kike-canaries/FifeFancy/pcb/3Dshapes/APFA2507.step

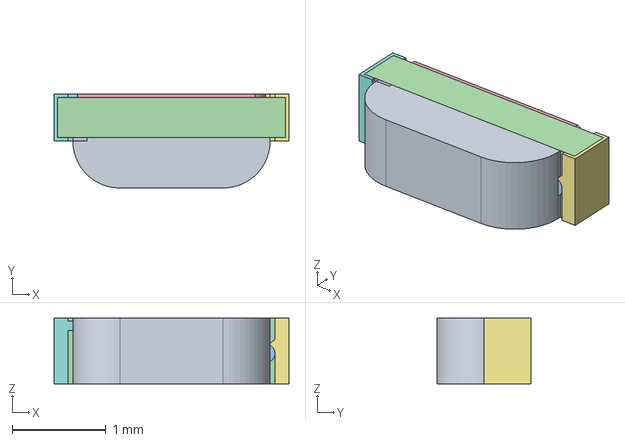
[picture p1: CAD file, 2021-09-05]
pcb/3Dshapes/APFA2507.step
2.50 x 1.00 x 0.7 mm
