kike-canaries/FifeFancy/pcb/3Dshapes/TL3340AF160QG.step

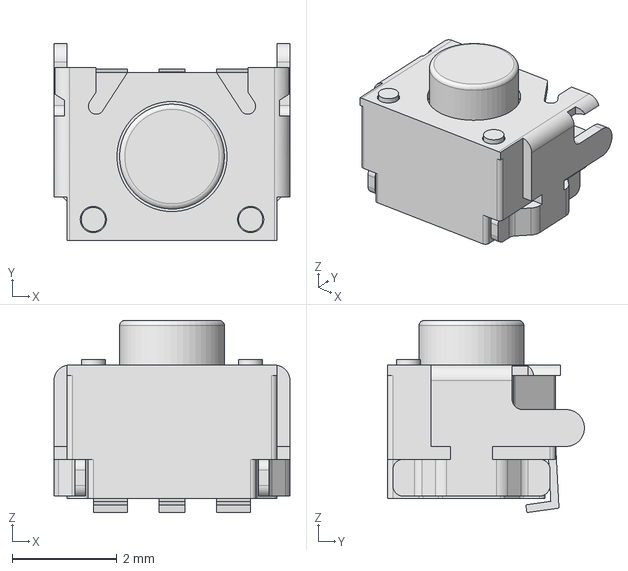
[picture p2: CAD file, 2021-09-05]
pcb/3Dshapes/TL3340AF160QG.step
4.50 x 3.75 x 3.67 mm
