kike-canaries/FifeFancy/pcb/3Dshapes/DX07P024MJ1R1500.step

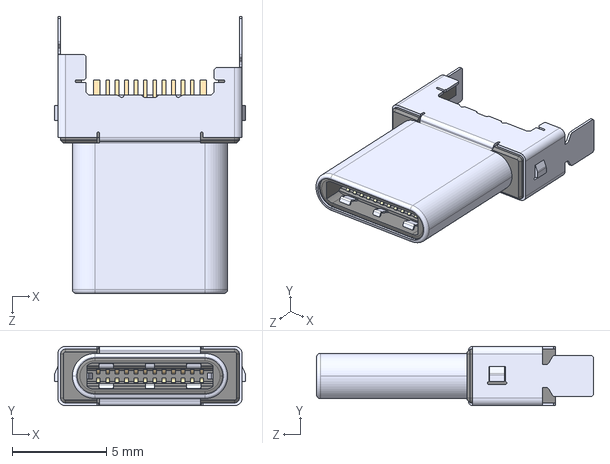
[picture p3: CAD file, 2021-09-05]
pcb/3Dshapes/DX07P024MJ1R1500.step
10.2 x 3.15 x 14.7 mm
