kike-canaries/FifeFancy/pcb/3Dshapes/XCL220.step

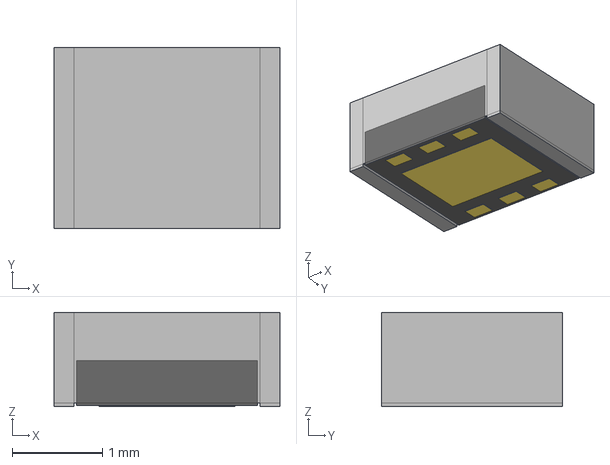
[picture p4: CAD file, 2021-09-03]
pcb/3Dshapes/XCL220.step
2.50 x 2.00 x 1.04 mm
