kike-canaries/FifeFancy/pcb/3Dshapes/W25Q16JVUXIQ_WIN.step

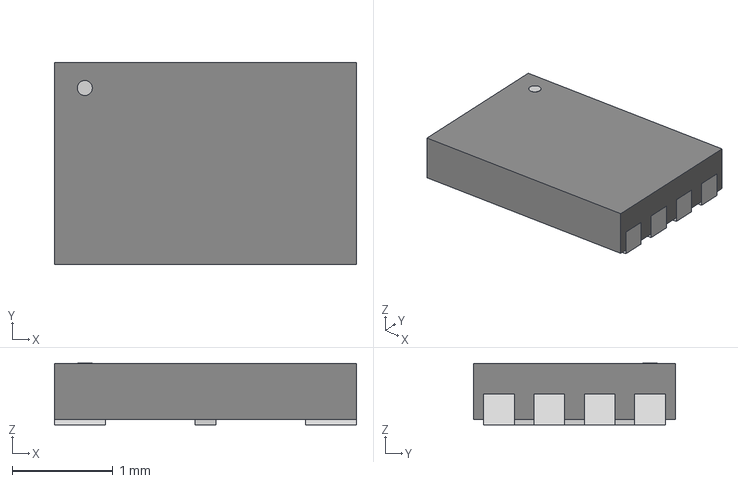
[picture p5: CAD file, 2021-09-03]
pcb/3Dshapes/W25Q16JVUXIQ_WIN.step
3.00 x 2.01 x 0.612 mm
