kike-canaries/FifeFancy/pcb/3Dshapes/Sensirion_CO2_Sensors_SCD4x_STEP_file.step

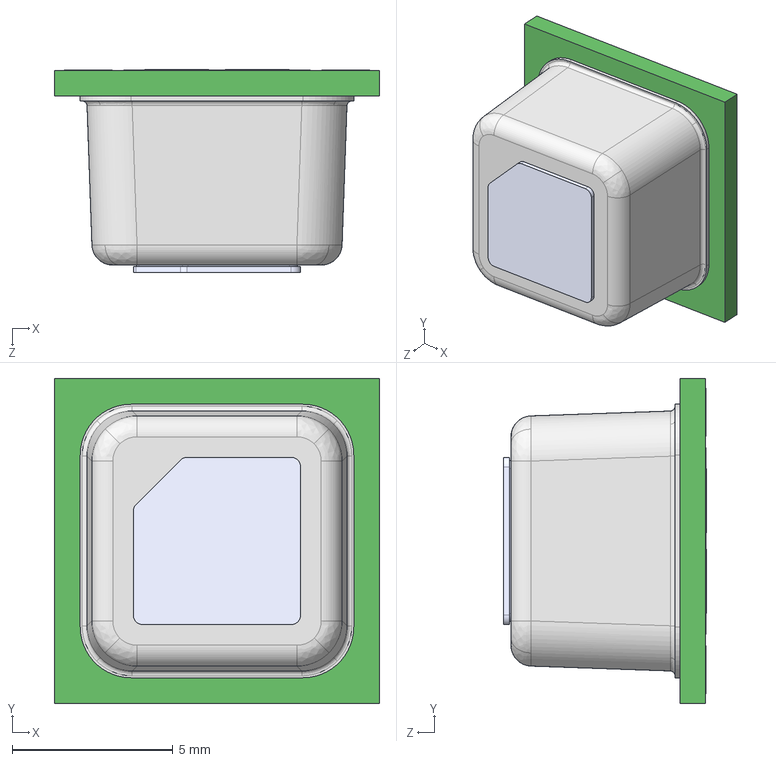
[picture p6: CAD file, 2021-09-01]
pcb/3Dshapes/Sensirion_CO2_Sensors_SCD4x_STEP_file.step
10.1 x 10.1 x 6.31 mm
