kike-canaries/FifeFancy/pcb/minimum.kicad_pcb

## KiCad design pcb/minimum.kicad_pcb (2021-09-07)

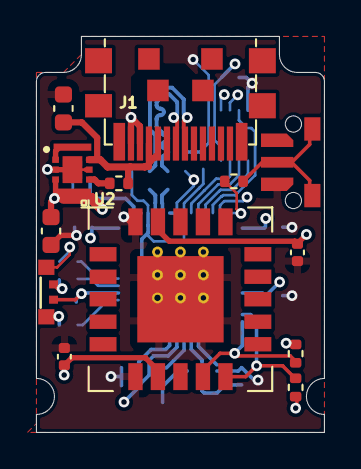
[picture p7: board minimum.kicad_pcb from above]

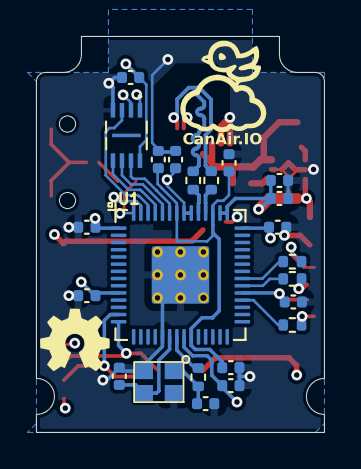
[picture p8: board minimum.kicad_pcb from below]

Board: 4 copper layers, 16.0 x 22.0 mm, 38 parts (25 on the bottom side), 28 nets.

Parts:
C1, C2, C3, C4, C5, C6, C7, C9, C12, C13, C16: 100n; C_0402_1005Metric
C8: 4.7u; C_0402_1005Metric
C10, C11: 1u; C_0402_1005Metric
C14, C15: 27p; C_0402_1005Metric
C17, C18: 10u; C_0603_1608Metric
D1: LED_BARG; RGB_LED_3x1
J1: DX07P024MJ1R1500; USB_C_Plug_UTC009-C12
LOGO1: LOGO; CanAir_IO
LOGO2: Logo_Open_Hardware_Small; OHW_LOGO
R1, R2: 27.4; R_0402_1005Metric
R3, R4: 2.2k; R_0402_1005Metric
R5, R6: 1k; R_0402_1005Metric
R7: 10k; R_0402_1005Metric
R8, R9, R10: 470; R_0402_1005Metric
SW1: SW_Push; TL3340AF160QG
U1: RP2040; RP2040-QFN-56
U2: SCD4x; QFN-20_EP_10.1x10.1_Pitch1.25mm
U3: W25Q16JVUXIQ
U4: XCL220
Y1: C2E-12.000-18-1020-X-R; AKER_C2E

Connections:
+1V1: C11.1, C12.1, C13.1, U1.23 (DVDD), U1.45 (VREG_VOUT), U1.50 (DVDD)
+3V3: C1.1, C2.1, C3.1, C4.1, C5.1, C6.1, C7.1, C8.1, C9.1, C10.1, C16.1, C18.1, D1.2 (A), R3.1, R4.1, U1.1 (IOVDD), U1.10 (IOVDD), U1.22 (IOVDD), U1.33 (IOVDD), U1.42 (IOVDD), U1.43 (ADC_AVDD), U1.44 (VREG_IN), U1.48 (USB_VDD), U1.49 (IOVDD), U2.7 (VDD), U2.19 (VDDH), U3.8 (VCC), U4.3 (Vout), U4.8 (L2)
/LED_B: R10.1, U1.32 (GPIO21)
/LED_G: R9.1, U1.35 (GPIO23)
/LED_R: R8.1, U1.34 (GPIO22)
/Pi_USB_D+: R1.2, U1.47 (USB_DP)
/Pi_USB_D-: R2.1, U1.46 (USB_DM)
/QSPI_SCLK: U1.52 (QSPI_SCLK), U3.6 (CLK)
/QSPI_SD0: U1.53 (QSPI_SD0), U3.5 (DI_IO0)
/QSPI_SD1: U1.55 (QSPI_SD1), U3.2 (DO_IO1)
/QSPI_SD2: U1.54 (QSPI_SD2), U3.3 (IO2)
/QSPI_SD3: U1.51 (QSPI_SD3), U3.7 (IO3)
/QSPI_SS: R6.2, U1.56 (QSPI_SS), U3.1 (CS)
/SCL: R3.2, U1.14 (GPIO11), U2.9 (SCL)
/SDA: R4.2, U1.13 (GPIO10), U2.10 (SDA)
/USB_D+: J1.A6 (DA+), R1.1
/USB_D-: J1.A7 (DA-), R2.2
/XIN: C14.2, U1.20 (XIN), Y1.3
/XOUT: R5.2, U1.21 (XOUT)
/XOUTc: C15.2, R5.1, Y1.1
GND: C1.2, C2.2, C3.2, C4.2, C5.2, C6.2, C7.2, C8.2, C9.2, C10.2, C11.2, C12.2, C13.2, C14.1, C15.1, C16.2, C17.2, C18.2, J1.A1 (GNDA), J1.B12 (GNDB), SW1.1, U1.19 (TESTEN), U1.57 (GND), U2.6 (GND), U2.20 (GND), U2.21 (GND), U3.4 (GND), U4.2 (AGND), U4.5 (PGND), U4.PAD, Y1.2, Y1.4
unnamed: D1.1 (BK), R10.2
unnamed: D1.3 (RK), R8.2
unnamed: D1.4 (GK), R9.2
unnamed: R6.1, SW1.2
unnamed: R7.2, U4.4 (CE)
unnamed: U4.1 (Lx), U4.7 (L1)
VBUS: C17.1, J1.A4 (A_VBUS), J1.B9 (B_VBUS), R7.1, U4.6 (Vin)
