kike-canaries/FifeFancy/(commit log)

2021-09-01 flash added
    [minimum.kicad_pcb, minimum.kicad_sch]
2021-09-01 connecting signals
    [minimum.kicad_pcb, minimum.kicad_sch]
2021-09-02 flash changed due to space constrains
    [minimum.kicad_pcb, minimum.kicad_sch]
2021-09-02 HIDING LABELS
    [minimum.kicad_pcb]
2021-09-03 missing libs added
    [W25Q16JVUXIQ_WIN.step, XCL220.step]
2021-09-05 USB plug connector changed to DX07P024MJ1R1500
    [DX07P024MJ1R1500.step, minimum.kicad_pcb]
2021-09-05 routing VBUS
    [minimum.kicad_pcb, minimum.kicad_sch]
2021-09-05 adding led and push button libs
    [APFA2507.step, TL3340AF160QG.step, minimum.kicad_pcb, minimum.kicad_sch]
2021-09-05 OH logo added
    [minimum.kicad_pcb, minimum.kicad_sch]
2021-09-06 changing the USB connector following the recommendation of arturo182
    [minimum.kicad_pcb, minimum.kicad_sch]
2021-09-06 DRC OK
    [minimum.kicad_pcb]
2021-09-06 CanAir.IO logo added
    [minimum.kicad_pcb]
2021-09-06 OpenHardware logo added
    [minimum.kicad_pcb, minimum.kicad_sch]
2021-09-06 useless fixes :/
    [minimum.kicad_pcb, minimum.kicad_sch]
2021-09-06 Fix common pin RGB Led
    [minimum.kicad_pcb, minimum.kicad_sch]
2021-09-07 solder past fixed
    [minimum.kicad_pcb]
2021-09-07 fabrication files
    [minimum-B_Cu.gbr, minimum-B_Mask.gbr, minimum-B_Paste.gbr, minimum-B_Silkscreen.gbr, minimum-Edge_Cuts.gbr, minimum-F_Cu.gbr, minimum-F_Mask.gbr, minimum-F_Paste.gbr]
